mmmspatz/midea_uart_board/midea_dongle.kicad_pcb

## KiCad design midea_dongle.kicad_pcb (2026-08-11)

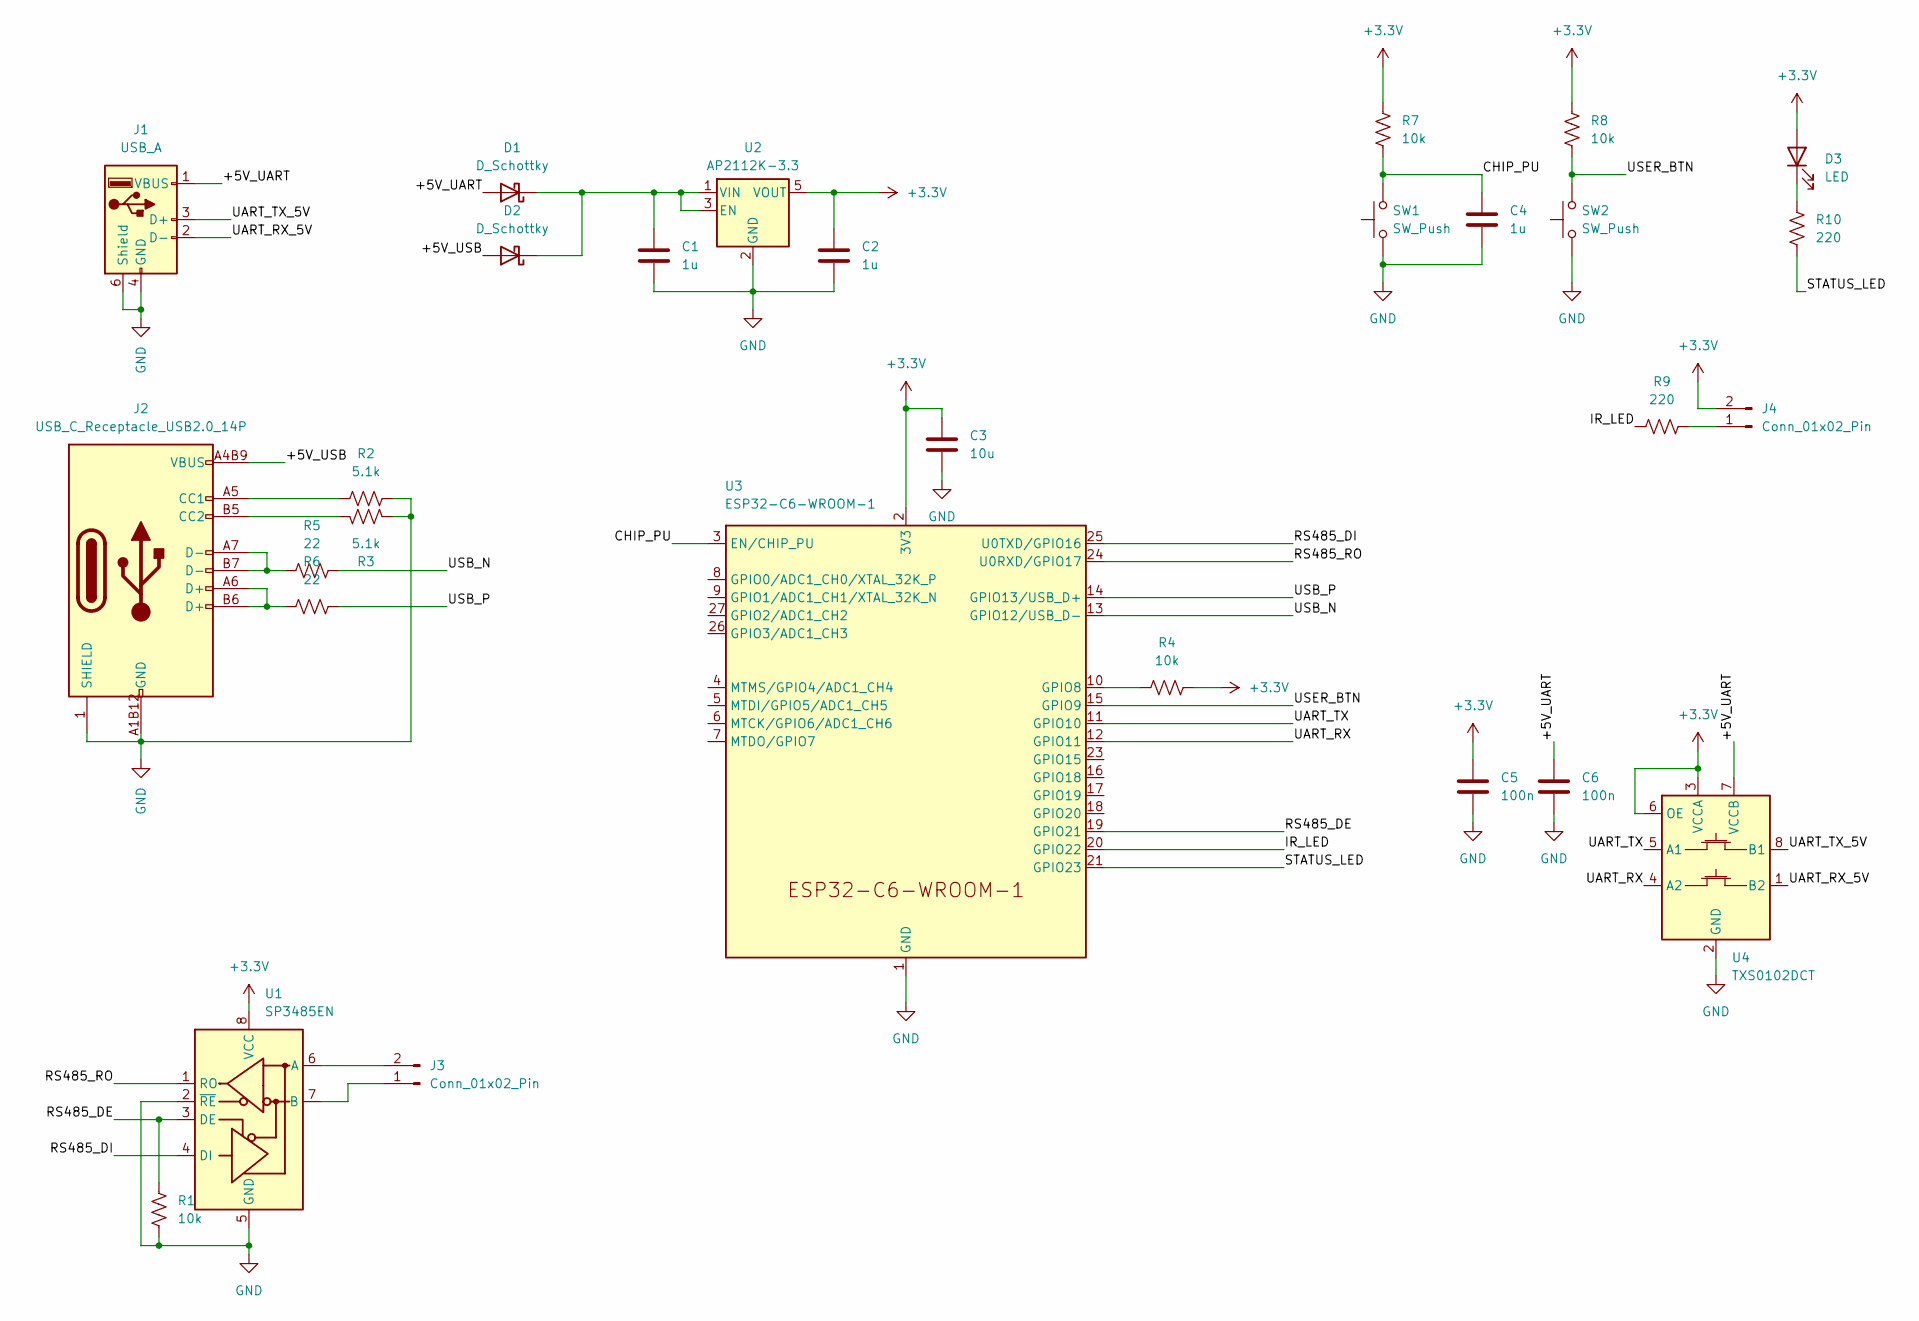
[picture p1: schematic midea_dongle.kicad_sch]

Parts:
C1, C2, C4: 1u; C_0402_1005Metric
C3: 10u; C_0603_1608Metric
C5, C6: 100n; C_0402_1005Metric
D1, D2: D_Schottky; D_SOD-123; LCSC C8598
D3: LED; LED_0603_1608Metric
J1: USB_A; USB-A-TH_U-G-04WD-W-01; LCSC C98125
J2: USB_C_Receptacle_USB2.0_14P; USB-C_SMD-TYPE-C-31-M-12_1; LCSC C165948
J3, J4: Conn_01x02_Pin; SMD_SOLPAD_1x02_p2.54mm
R1, R4, R7, R8: 10k; R_0402_1005Metric; LCSC C25744
R2, R3: 5.1k; R_0402_1005Metric
R5, R6: 22; R_0402_1005Metric
R9, R10: 220; R_0402_1005Metric
SW1, SW2: SW_Push; SW-SMD_L3.9-W3.0-P4.45
U1: SP3485EN; SOIC-8_3.9x4.9mm_P1.27mm
U2: AP2112K-3.3; SOT-23-5; LCSC C51118
U3: ESP32-C6-WROOM-1; LCSC C5366877
U4: TXS0102DCT; SSOP-8_2.95x2.8mm_P0.65mm

Connections:
+3.3V: C2.1, C3.1, C5.1, D3.2 (A), J4.2, R4.2, R7.2, R8.2, U1.8 (VCC), U2.5 (VOUT), U3.2 (3V3), U4.3 (VCCA), U4.6 (OE)
/+5V_UART: C6.1, D1.2 (A), J1.1 (VBUS), U4.7 (VCCB)
/+5V_USB: D2.2 (A), J2.A4B9 (VBUS), J2.B4A9 (VBUS)
/CHIP_PU: C4.1, R7.1, SW1.2, U3.3 (EN/CHIP_PU)
/IR_LED: R9.2, U3.20 (GPIO22)
/RS485_DE: R1.1, U1.3 (DE), U3.19 (GPIO21)
/RS485_DI: U1.4 (DI), U3.25 (U0TXD/GPIO16)
/RS485_RO: U1.1 (RO), U3.24 (U0RXD/GPIO17)
/STATUS_LED: R10.1, U3.21 (GPIO23)
/UART_RX: U3.12 (GPIO11), U4.4 (A2)
/UART_RX_5V: J1.2 (D-), U4.1 (B2)
/UART_TX: U3.11 (GPIO10), U4.5 (A1)
/UART_TX_5V: J1.3 (D+), U4.8 (B1)
/USB_N: R5.2, U3.13 (GPIO12/USB_D-)
/USB_P: R6.2, U3.14 (GPIO13/USB_D+)
/USER_BTN: R8.1, SW2.2, U3.15 (GPIO9)
GND: C1.2, C2.2, C3.2, C4.2, C5.2, C6.2, J1.4 (GND), J1.5 (Shield), J1.6 (Shield), J2.1 (SHIELD), J2.2 (SHIELD), J2.3 (SHIELD), J2.4 (SHIELD), J2.A1B12 (GND), J2.B1A12 (GND), R1.2, R2.2, R3.2, SW1.1, SW2.1, U1.2 (~RE), U1.5 (GND), U2.2 (GND), U3.1 (GND), U3.28 (GND), U3.29 (GND), U4.2 (GND)
unnamed: C1.1, D1.1 (K), D2.1 (K), U2.1 (VIN), U2.3 (EN)
unnamed: D3.1 (K), R10.2
unnamed: J2.A5 (CC1), R2.1
unnamed: J2.B5 (CC2), R3.1
unnamed: J2.A6 (D+), J2.B6 (D+), R6.1
unnamed: J2.A7 (D-), J2.B7 (D-), R5.1
unnamed: J3.1, U1.7 (B)
unnamed: J3.2, U1.6 (A)
unnamed: J4.1, R9.1
unnamed: R4.1, U3.10 (GPIO8)

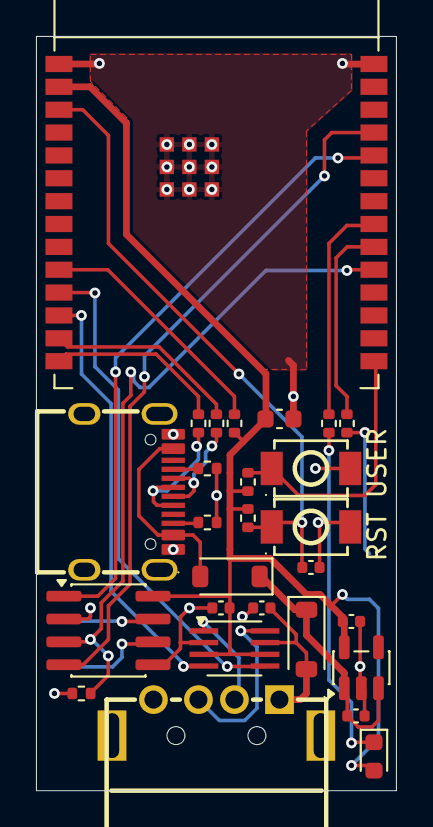
[picture p2: board midea_dongle.kicad_pcb from above]

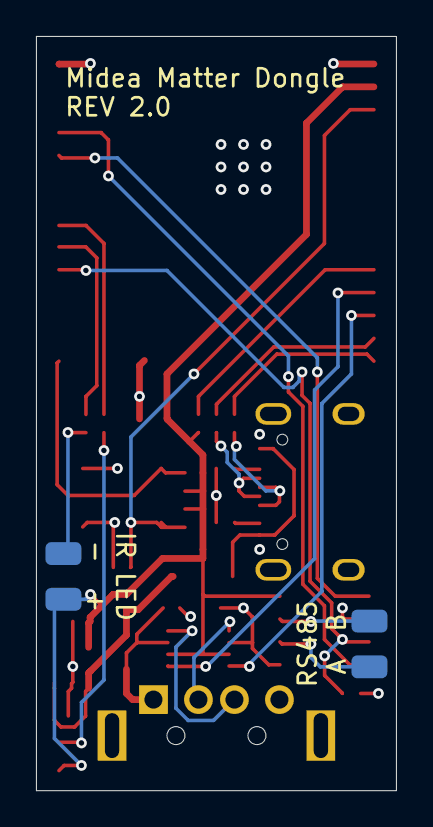
[picture p3: board midea_dongle.kicad_pcb from below]

Board: 4 copper layers, 20.0 x 41.9 mm, 29 parts (2 on the bottom side), 27 nets.
