mmmspatz/midea_uart_board/(commit log)

2026-08-09 add rev1 production files
    [BOM-midea_dongle.csv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]
2026-08-11 5V bypass cap, correct button silk
    [BOM-midea_dongle.csv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]
